AlexanderGruhl/Robotic_Manipulator_Conveyor_Belt_Project/Raw Image Calculations/Robot Manipulator Diagram.jpg

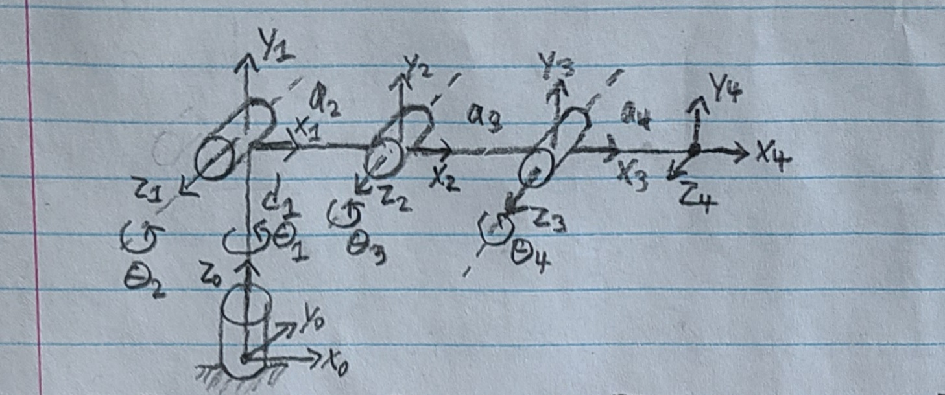
Raw Image Calculations/Robot Manipulator Diagram.jpg
