AlexanderGruhl/Robotic_Manipulator_Conveyor_Belt_Project/Raw Image Calculations/DH Calculations.jpg

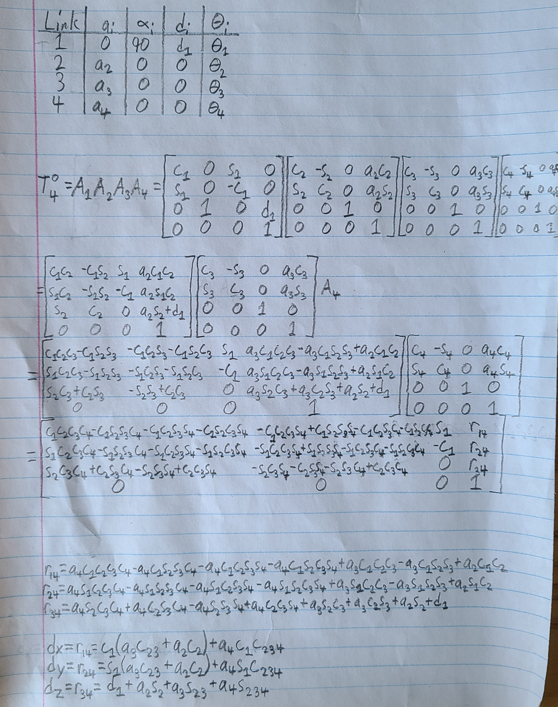
Raw Image Calculations/DH Calculations.jpg
