AlexanderGruhl/Robotic_Manipulator_Conveyor_Belt_Project/README.md

# Robotic_Manipulator_Conveyor_Belt_Project
Robotic manipulator that sorts objects based on their colour
