AlexanderGruhl/Robotic_Manipulator_Conveyor_Belt_Project/Raw Image Calculations/Calculated Angles.jpg

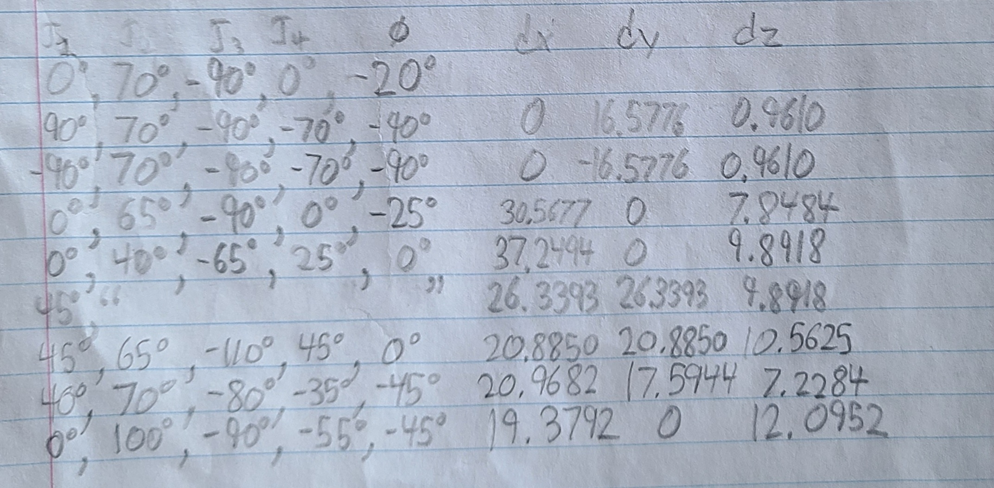
Raw Image Calculations/Calculated Angles.jpg
