AlexanderGruhl/Robotic_Manipulator_Conveyor_Belt_Project/(commit log)

2021-04-26 V1 of code and matlab code for DH forward kinematics
2021-05-05 Added project report and test code for conveyor belt and colour sensor
